SyWier/RGBlinker/README.md

# RGBlinker

Light up your love! RGBlinker’s heart-shaped PCB pulses vibrant RGB colors, driven by an STM32 and powered by a CR2032 battery.

**hw**:
Altium project of the hardware.

**sw**:
STM32 code of the software.
