SyWier/RGBlinker/hw/README.md

# Hardware
PCB designed in **Altium Designer** (version 24.9.1)

Design parameters:
- Microcontroller: **STM32C031K6U6**
- Power source: **CR2032** coin cell battery
- Max power consumption (if all LEDs are bright white): **7.6mA**
- Boost converter to **3.3V** (for the blue and green LEDs)
- **Button** to turn on/off and switch animations
- **TAG-Connect** to program the microcontroller
