SyWier/RGBlinker/hw/Shape/heart.png

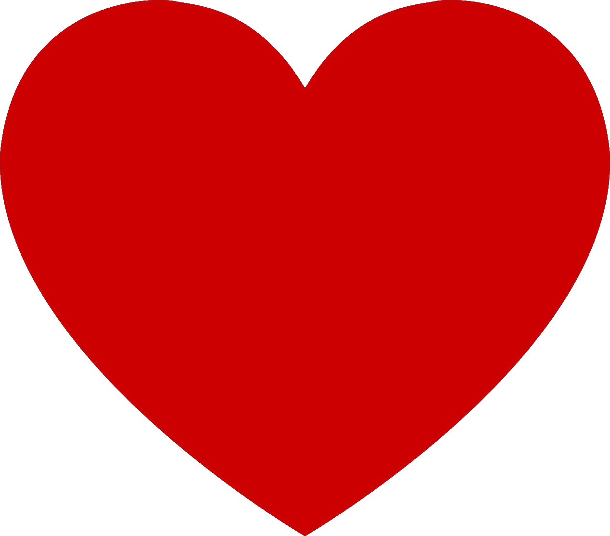
hw/Shape/heart.png
