SyWier/RGBlinker/hw/Shape/heart.dxf

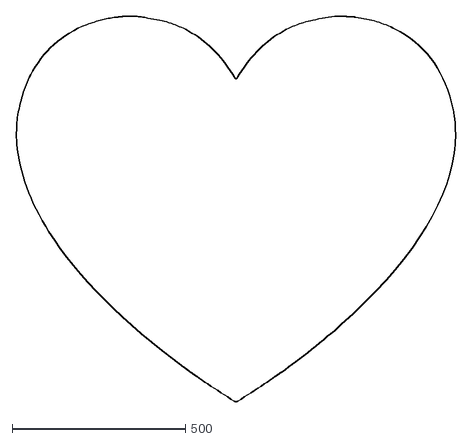
[picture p2: CAD file, 2025-10-28]
hw/Shape/heart.dxf
1267.9 x 1113.2
