SyWier/RGBlinker/(list of files, drawings)

Other design files:
hw/Altium/Main.SchDoc
hw/Altium/RGBlink.PcbDoc
hw/Altium/RGBlinker.PrjPcb
hw/Altium/RGBlinker.SchLib
