SyWier/RGBlinker/sw/RGBlinky/Core/Src/main.c

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
/* Includes ------------------------------------------------------------------*/
#include "main.h"
#include "adc.h"
#include "tim.h"
#include "usart.h"
#include "gpio.h"

/* USER CODE BEGIN Includes */
#include "log.h"
#include "led.h"
#include "battery.h"
#include "button_handler.h"
#include "animation.h"
#include "eeprom.h"

// Redirect printf to UART
int _write(int file, char *ptr, int len) {
	HAL_UART_Transmit(&huart1, (const uint8_t*) ptr, (uint16_t) len, HAL_MAX_DELAY);
	return HAL_OK;
}

volatile bool tickFlag = 0;
/* USER CODE END Includes */


void SystemClock_Config(void);
/**
  * @brief  The application entry point.
  * @retval int
  */
int main(void)
{

  /* MCU Configuration--------------------------------------------------------*/

  /* Reset of all peripherals, Initializes the Flash interface and the Systick. */
  HAL_Init();

  /* Configure the system clock */
  SystemClock_Config();

  /* Initialize all configured peripherals */
  MX_GPIO_Init();
  MX_ADC1_Init();
  MX_USART1_UART_Init();
  MX_TIM3_Init();
  MX_TIM14_Init();
  /* USER CODE BEGIN 2 */

	/* Build Print Build Time */
    log_message(LOG_IMP, "BUILD", "Build time: " __DATE__ " " __TIME__);
    log_message(LOG_IMP, "BUILD", "Hardware version: " HW_VERSION);
    log_message(LOG_IMP, "BUILD", "Software version: " SW_VERSION);

//	Log_Error("Reset status: %x", RCC->CSR2);

	// Check if we were in standby mode
	if(__HAL_PWR_GET_FLAG(PWR_FLAG_WUF3)) {
		log_message(LOG_INF, "MAIN", "Device waked up.");
	} else {
		log_message(LOG_INF, "MAIN", "Device powered up.");
	}
	__HAL_PWR_CLEAR_FLAG(PWR_FLAG_WUF3);


	// EEPROM_Emul
	eeprom_start();

	/* Init components */
	Led_Init();
	Button_Init(&userBtn);

	/* Start timers */
	HAL_TIM_Base_Start_IT(&htim3);
	HAL_TIM_Base_Start_IT(&htim14);

	Battery_Init();
	Battery_Gauge();
  /* USER CODE END 2 */

  /* Infinite loop */
  /* USER CODE BEGIN WHILE */

	/* Infinite loop */
	log_message(LOG_INF, "MAIN", "Start main...");

	animationFlag = 1;

	while (1) {
		if(tickFlag) {
			tickFlag = 0;
			Button_Tick(&userBtn);
			Animate();
		}
    /* USER CODE END WHILE */

    /* USER CODE BEGIN 3 */
	}
  /* USER CODE END 3 */
}

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
