SyWier/RGBlinker/sw/RGBlinky/Core/Inc/main.h

#define HW_VERSION "hw-v1.0"
#define SW_VERSION "sw-v1.3"
#define DEBUG_UART_TX_Pin GPIO_PIN_14
#define DEBUG_UART_TX_GPIO_Port GPIOC
#define LEDA0_Pin GPIO_PIN_0
#define LEDA0_GPIO_Port GPIOA
#define LEDA1_Pin GPIO_PIN_1
#define LEDA1_GPIO_Port GPIOA
#define LEDA2_Pin GPIO_PIN_2
#define LEDA2_GPIO_Port GPIOA
#define LEDA3_Pin GPIO_PIN_3
#define LEDA3_GPIO_Port GPIOA
#define LEDK0_Pin GPIO_PIN_4
#define LEDK0_GPIO_Port GPIOA
#define LEDK1_Pin GPIO_PIN_5
#define LEDK1_GPIO_Port GPIOA
#define LEDK2_Pin GPIO_PIN_6
#define LEDK2_GPIO_Port GPIOA
#define LEDK3_Pin GPIO_PIN_7
#define LEDK3_GPIO_Port GPIOA
#define DEBUG_UART_RX_Pin GPIO_PIN_2
#define DEBUG_UART_RX_GPIO_Port GPIOB
#define LEDK4_Pin GPIO_PIN_8
#define LEDK4_GPIO_Port GPIOA
#define LEDK5_Pin GPIO_PIN_9
#define LEDK5_GPIO_Port GPIOA
#define LEDK6_Pin GPIO_PIN_10
#define LEDK6_GPIO_Port GPIOA
#define LEDK7_Pin GPIO_PIN_11
#define LEDK7_GPIO_Port GPIOA
#define LEDK8_Pin GPIO_PIN_12
#define LEDK8_GPIO_Port GPIOA
#define EN_3V3_Pin GPIO_PIN_3
#define EN_3V3_GPIO_Port GPIOB
#define BTN_Pin GPIO_PIN_6
#define BTN_GPIO_Port GPIOB
