SyWier/RGBlinker/sw/RGBlinky/Core/Components/eeprom.h

/*
 * eeprom.h
 *
 *  Created on: Jul 16, 2025
 *      Author: Daniel
 */

#ifndef COMPONENTS_EEPROM_H_
#define COMPONENTS_EEPROM_H_

#include "main.h"

void eeprom_init(void);
void eeprom_write(void);

#endif /* COMPONENTS_EEPROM_H_ */
