SyWier/RGBlinker/sw/RGBlinky/Core/Components/led.h

/*
 * led.h
 *
 *  Created on: Jun 12, 2025
 *      Author: Daniel
 */

#ifndef COMPONENTS_LED_H_
#define COMPONENTS_LED_H_ű

#include "main.h"



#define LED_ROWS 4
#define LED_NUM 9
#define LED_CNT LED_ROWS * LED_NUM

#define RGB_BUFFER_SCALE 2
#define RGB_BRIGHTNESS_MAX 4
extern uint8_t RgbBrigntnessScale;
extern uint8_t _RgbBrigntnessScale_old;

#define LED_PWM_MAX ( (256>>RGB_BUFFER_SCALE) - 1 )
#define BUFFER_SIZE LED_ROWS * LED_PWM_MAX
#define BUFFER_COUNT 2

extern uint16_t LedBuffer[BUFFER_COUNT][BUFFER_SIZE]; // Size = BUFFER_COUNT * BUFFER_SIZE * 2 byte
extern bool BufferSelect;

#ifdef HW_V1_0
#define RGB(r, g, b)  ((uint8_t)(b)), ((uint8_t)(g)), ((uint8_t)(r))
#elif defined(HW_V1_1)
#define RGB(r, g, b)  ((uint8_t)(r)), ((uint8_t)(g)), ((uint8_t)(b))
#endif

#define FILL_RGB(r, g, b) \
    RGB(r, g, b), RGB(r, g, b), RGB(r, g, b), RGB(r, g, b), \
    RGB(r, g, b), RGB(r, g, b), RGB(r, g, b), RGB(r, g, b), \
    RGB(r, g, b), RGB(r, g, b), RGB(r, g, b), RGB(r, g, b)

#define FILL_RED(val)     FILL_RGB(val, 0, 0)
#define FILL_GREEN(val)   FILL_RGB(0, val, 0)
#define FILL_BLUE(val)    FILL_RGB(0, 0, val)
#define FILL_WHITE(val)   FILL_RGB(val, val, val)

void Led_Init();
void Led_Fill_Buffer(uint16_t color);
void Led_Generate_Buffer(const uint8_t frame[LED_CNT]);
void Led_Test(uint32_t colorRaw);

#endif /* COMPONENTS_LED_H_ */
