SyWier/RGBlinker/(commit log)

2025-03-26 Added Altium project
    [Main.SchDoc, RGBlink.PcbDoc, RGBlinker.PrjPcb, RGBlinker.SchLib]
2025-03-26 Modified MCU layout, removed silkscreen texts
    [RGBlink.PcbDoc]
2025-03-26 Routed IC, replace battery holder with isolated one
    [Main.SchDoc, RGBlink.PcbDoc]
2025-03-27 Finished routing PCB
    [Main.SchDoc, RGBlink.PcbDoc]
2025-03-27 Adjusted trace width
    [Main.SchDoc, RGBlink.PcbDoc]
2025-03-27 Adjusted soldermask
    [RGBlink.PcbDoc]
2025-03-27 Added suppliers
    [Main.SchDoc, RGBlink.PcbDoc, RGBlinker.SchLib]
2025-03-27 Tented vias, increased silkscreen border width
    [RGBlink.PcbDoc]
2025-03-27 Added via stitching
    [RGBlink.PcbDoc]
2025-03-27 Added debug uart to tag connect
    [Main.SchDoc, RGBlink.PcbDoc]
2025-03-27 Small adjustements
    [RGBlink.PcbDoc]
2025-03-29 Small changes
    [RGBlink.PcbDoc]
2025-03-30 Modified resistor values
    [Main.SchDoc, RGBlinker.SchLib]
2025-03-30 Modified button resistor
    [Main.SchDoc, RGBlink.PcbDoc, RGBlinker.SchLib]
2025-06-01 Added STM32 software to the project
2025-06-01 Renamed project folders
    [Main.SchDoc, RGBlink.PcbDoc, RGBlinker.PrjPcb, RGBlinker.SchLib]
2025-06-01 Updated STM32 README.md
2025-06-08 Added STM32 project files
2025-06-09 Changed DMA to TIM interrupt
    C0 series DMA cannot access the GPIO bus
2025-06-09 Added button handler
    Should rework for better logic
2025-06-09 Removed button IT
2025-06-09 Fixed LED footprint
    This causes blue and red color to swap
    [Main.SchDoc, RGBlink.PcbDoc]
2025-06-09 Measure battery voltage and estimate battery percentage
2025-06-11 Refactored code base
    Also refactored button logic
2025-06-12 Turn off LEDs to indicate long press
2025-06-12 LEDs shows battery gauge at startup
2025-06-14 Optimized Timer Interrupt
2025-06-18 GPIO Pulldown on 3.3V enable pin when in Shutdown mode
    Before the floating pin occasionally turned on the boost converter
2025-06-18 Added simple battery gauge animation
2025-06-18 Automatically shutdown after 1 hour
    Created power off function
2025-06-18 Basic frame by frame animation
2025-06-18 Moved RGB_SCALE to pwm generation
2025-06-18 Load and repeat doesnt take frameTime
2025-06-18 Added back load frameTime
2025-06-18 Fixedf battery gauge animation
    [battery.c]
2025-06-18 Updated battery percentage calculation
2025-06-21 Over engineered battery gauge
    Now the button can skip to the animations
    [animation.c, battery.c, led.h, main.c]
2025-06-24 Updated button state machine
    Now I can sleep peacefully
2025-06-25 Button extra function: change brightness
    Setting will be forgotten after shutdown
2025-06-25 Optimize power consumption
    Lowered clock speeds
2025-06-25 More clock changes to improve button flow
2025-06-29 Led buffer generation optimalization
2025-07-07 Adjusted brightness scale
    Linear scaling with rounding up, so low-order bits wont become all black
    [RGBlinky Release.cfg]
2025-07-14 Simplified animation
    Added printf and button IT
2025-07-14 Code size optimalization
    To prevent critical optimalization added volatile for tickFlag and for HAL PWR .c file -> Setting/Misc/Flags: -O0
    [animation.c, button_handler.c, led.c, main.c, main.h]
2025-07-16 Save current animation index to EEPROM
2025-10-28 New boost converter and STM32L051 MCU
    In order to increase efficiency
    [Main.SchDoc, RGBlink.PcbDoc, RGBlinker.PrjPcb, RGBlinker.SchLib, heart.dxf]
2026-06-18 Change MCU to STM32U073
    [Main.SchDoc, RGBlinker.SchLib]
2026-06-20 Arrange components in a circle
    [Main.SchDoc, RGBlink.PcbDoc]
2026-06-20 Route circle components
    [Main.SchDoc, RGBlink.PcbDoc]
2026-07-03 Route LEDs and components
    [Main.SchDoc, RGBlink.PcbDoc, RGBlinker.SchLib]
2026-07-21 Add planes and via stiching
    [RGBlink.PcbDoc]
